NIYUGE666/cuddly-robot/docs/DESIGN.md

# 设计说明与校准

## 图纸版本

Rev B 将原理图改为单张 A0、有实际导线的功能分区图；四路从左到右依次为两级带通、两级移相、极性与幅度，右侧求和、底部电源。TL082 使用 A/B 放大单元和独立电源单元。修订仅改善表达及交换兼容性，PCB 铜线、器件编号和电路参数不变。BOM 的 Sheet 列表示功能分组，不代表 Rev B 的独立图纸页。

## 指标与实现

本设计选择文档中的方波方案，不采用三角波。电源为外部稳压 +12 V / 0 V / −12 V，不含市电电源模块。所有地均为同一 GND。NE555、CD4013 仅接 +12 V 和 GND；TL082 的 8 脚接 +12 V、4 脚接 −12 V，不能把 NE555 跨接在 24 V 两端。

信号链：NE555 → CD4013 /2 → 隔直、源幅度调整、TL082 缓冲 → 四路两级 MFB 带通 → 两级一阶全通 → 极性选择 → 幅度调整和缓冲 → 反相加法器 → 反相恢复 → 输出隔离电阻。

源输入为以 0 V 为中心的 ±5 V 方波。其正弦展开为

`v(t) = (20/π)[sin(ωt) + sin(3ωt)/3 + sin(5ωt)/5 + sin(7ωt)/7 + …]`，`ω = 2π × 1000`。

| 通道 | 频率 | 目标峰值 Vpk | 目标峰峰值 Vpp | 相对幅度 |
|---|---:|---:|---:|---:|
| H1 | 1 kHz | 6.3662 V | 12.7324 V | 1 |
| H3 | 3 kHz | 2.1221 V | 4.2441 V | 1/3 |
| H5 | 5 kHz | 1.2732 V | 2.5465 V | 1/5 |
| H7 | 7 kHz | 0.9095 V | 1.8189 V | 1/7 |

这些是各路**目标频率分量**的幅度，不是把 10 Vpp 方波的峰值 5 V 直接当作基波峰值。实际支路会含有少量带外谐波，推荐用示波器 FFT / 频谱测量，不能仅靠整条支路的总 Vpp 判断分量幅度。

## 方波发生及定标

U1=NE555P，R1=10 kΩ，R2=27 kΩ，RV1=20 kΩ，C1=10 nF。采用常见无稳态接法：2、6 脚接定时电容上端；7 脚为两个充放电电阻的中点；4 脚接 +12 V；5 脚以 10 nF 对地去耦。

`f555 ≈ 1.443 / [(R1 + 2(R2 + RV1_used)) C1]`。RV1 的使用阻值初设约 4.07 kΩ，得到约 2 kHz。

U2=CD4013BE，D1 接 /Q1，CLK1 接 NE555 输出。Q1 每个时钟沿翻转，从而产生 1 kHz、50% 占空比方波，不依赖 NE555 自身占空比。第一个触发器的 SET/RESET 接地；备用触发器 RESET 接 +12 V，其余输入接地，12/13 脚留空。CD4013 在 12 V 供电下可接受 NE555 的高电平；最终仍需实测电平裕量和占空比。

Q1 经 C3=10 µF/25 V 隔直，C3 正极朝 Q1。R3=1 MΩ 与 RV2=100 kΩ 提供对地直流回路，U3A 缓冲 RV2 的滑动端。等效隔直时间常数约 0.91 s，因此上电约 5 s 后再校准。RV2 初设滑动端对地约占总阻值 83.3%，微调至 TP2/SQ=10.00 Vpp。理论半周期下垂约 0.055%；这不是理想的直流电平移位器。

U3B 将 SQ 反相，提供 TP3/SQ_INV 作为辅助观察点；该单元没有悬空。

## 四路带通

每路由两个相同的多反馈 MFB 二阶带通串联构成，合计四阶。设中间节点为 N、反相端为 INV、输出为 O：

* 输入 → R1f → N；N → R2f → GND。
* N → C1f → O；N → C2f → INV。
* O → R3f → INV；运放同相端接 GND。

这里的 R1f/R2f/R3f 是拓扑参数名，具体参考号见 BOM 和原理图。

`H(s) = −s R3f C2f/R1f / [s² R3f C1f C2f + s(C1f+C2f) + 1/R1f + 1/R2f]`。

采用 `C1f=C2f=C`、`R1f=220 kΩ`、`R3f=470 kΩ`、`R2f=430 Ω + 200 Ω 多圈微调`。

理想模型：`f0 = sqrt[(1/R1f+1/R2f)/(R3f C²)]/(2π)`；`Q = π f0 R3f C`；中心增益 `−R3f/(2R1f) ≈ −1.0682`。每个中心频率处两级反相相消，两级增益约 1.141，从而给后续衰减调幅留下余量。

| 通道 | 滤波 IC | 每级 C1f/C2f | 两个中心频率电位器 | 有限带宽模型中电位器使用阻值 |
|---|---|---|---|---:|
| H1 | U4 | 10 nF | RV3、RV4 | 各约 104.92 Ω |
| H3 | U7 | 3.3 nF | RV8、RV9 | 各约 105.07 Ω |
| H5 | U10 | 2 nF | RV13、RV14 | 各约 83.55 Ω |
| H7 | U13 | 1.5 nF | RV18、RV19 | 各约 24.34 Ω |

每级 Q 约 15。滤波电容选 C0G/NP0 或薄膜、1%，同一级两只尽量匹配；不可随意换成有明显电压系数的高容值陶瓷电容。由于 TL082 带宽有限，特别是 7 kHz，**上表是单极点模型初值，不是免调实物阻值**。频率、增益和相位都需要校准。

## 相位与幅度

U5/U8/U11/U14 的两个单元各构成一个全通：同相端接输入经可调 R、C 对地形成的低通节点；反相端用两只相等 10 kΩ 电阻连接输入和输出。

`Hap(s) = (1−sRC)/(1+sRC)`，`φ = −2 arctan(ωRC)`。每级的 R 是 `100 Ω + 200 kΩ 电位器`，C 与所属通道的滤波电容值相同。两级串联提供接近一周的可调范围，再经反相器与三针跳线选择极性，能够覆盖完整 360° 的所需相位。

J1/J2/J3/J4 默认各接一个 **2–3 短路帽**，选择反相输出；1–2 选择不反相。**不可同时短接三针**，否则会连接两个反相输出。相位初设为每级约 −90°，两级合计 −180°，再经反相补偿到 0°。

| 通道 | 相位电位器 | 模型初设：每只使用阻值 | 幅度电位器 | 模型幅度比例：滑动端对地 / 总阻值 |
|---|---|---:|---|---:|
| H1 | RV5、RV6 | 15.797 kΩ | RV7 | 0.8804 |
| H3 | RV10、RV11 | 15.920 kΩ | RV12 | 0.8811 |
| H5 | RV15、RV16 | 15.723 kΩ | RV17 | 0.8827 |
| H7 | RV20、RV21 | 14.934 kΩ | RV22 | 0.8860 |

所有以可变电阻使用的电位器都已把 2 脚滑动端与 3 脚相连；断续接触时不会完全开路。相位电位器与滤波电位器调的是 1→2/3 的电阻，幅度电位器则作为三端分压器，不能混淆。

U6/U9/U12/U15 的 A 单元提供极性反相，B 单元缓冲幅度滑动端。每路幅度可从近 0 调至滤波后最大值。原始方波已具有 1/n 系数，因此各路幅度电位器的最终位置接近，而不是分别设置成 1、1/3、1/5、1/7。

## 求和、电源及接口

四路通过各自 100 kΩ 电阻进入 U16A，反馈也是 100 kΩ，得到反相和；U16B 用 100 kΩ / 100 kΩ 再反相，得到同相输出。R69=100 Ω 串联隔离到输出端。求和及反相电阻建议用 0.1%。

| 接口 / 测试点 | 含义 |
|---|---|
| J5-1 / J5-2 / J5-3 | +12 V / GND / −12 V，极性必须核对 |
| J6-1 / J6-2 | OUT / GND |
| TP1 / TP2 / TP3 | 2 kHz 时钟 / SQ / 反相 SQ |
| TP4 / TP7 / TP10 / TP13 | H1/H3/H5/H7 两级带通输出 |
| TP5 / TP8 / TP11 / TP14 | H1/H3/H5/H7 两级全通输出，极性选择前 |
| TP6 / TP9 / TP12 / TP15 | 四路最终幅度缓冲输出 |
| TP16 / TP17 / TP18 | SUM_RAW / OUT / GND |

每个 IC 配 100 nF 正电源去耦，TL082 另外配 100 nF 负电源去耦。入口两只 47 µF/25 V 电解分别跨接正、负电源；**负电源电解正极接 GND**。推荐外部稳压电源每路可供 200 mA，首次限流上电并确认无异常后再提高限流。没有板载电源极性保护。

示波器使用高阻 10× 探头，输出负载建议 ≥100 kΩ；1 MΩ 仪器输入更合适。不可接 50 Ω 终端，也不作为耳机/扬声器驱动器。输出电阻对 100 kΩ 负载的幅度影响约 −0.1%。

## 实物校准流程

1. 断电检查焊接、电源极性和 IC 方向。22 只电位器按上表预置；J1–J4 各放一个 2–3 短路帽。幅度先调小。上电检查各 TL082 的 8/4 脚电源以及 U1/U2 电源，等待约 5 s。
2. 调 RV1，使 TP1≈2.000 kHz、TP2≈1.000 kHz；观察 TP2 占空比约 50%。调 RV2，使 TP2 为 10.00 Vpp、平均电压接近 0 V。温漂后可能需要重调频率。
3. 对每路单独校准两个滤波段。用 FFT 分析目标谐波，在目标频率固定时交替小幅调整两个 200 Ω 电位器，使各级对应的目标谐波幅度最大。若有信号发生器，可临时隔离源驱动，再用所属频率的正弦波校准；**不可把外部发生器直接并接到正在工作的 SQ 输出**。
4. 示波器以 SQ 的上升沿为共同时间原点。调整两只相位电位器及必要的极性跳线，使各通道目标谐波在该时间点为正向过零，即 `sin(nωt)` 的相位约 0°。建议用 FFT 相位/拟合正弦检查，因为残余谐波会影响肉眼判断过零。对每路只看自己的目标频率，不能把所有波形的周期误认为相同。
5. 交替微调相位与幅度，令四路目标分量达到表中 Vpk 值。使用同一测量通道、同一探头衰减倍率。建议目标：幅度比例误差 ≤2%，对应谐波相位误差 ≤2°；这是待实物验证的调试目标，不是自动检查证实的实物指标。
6. 测 TP16/TP17，确认四项合成近似方波；记录频率、源 Vpp、四路频谱幅度/相位及合成波形。过冲属于有限项傅里叶合成的正常现象，不能通过误调某一路幅度来强行消除。

若希望最终 OUT 总 Vpp 约 10 V，可把四路同时缩放约 `10/11.84≈0.845`，保留相对幅度关系。这会改变绝对傅里叶系数；默认设计按原始 10 Vpp 方波的傅里叶系数校准。

## PCB 和装配

板外形 229 × 231 mm，双层，FR-4 1.6 mm，建议 1 oz 铜。采用较大的插件实验板便于焊接、测量和反复调试，未针对最低板价或最小面积优化。所有信号/电源线最小宽度 0.25 mm，间距下限 0.20 mm，过孔 0.60/0.30 mm。低频电路仍需关注公共地阻抗；本版采用明确的地走线，没有宣称经过 EMI/串扰或电源完整性验证。

固定电阻是 DIN0207、7.62 mm 脚距；非极性电容是 5 mm 脚距；电解是直径 5 mm、2 mm 脚距；多圈电位器为 Bourns 3296W 立式封装。采购时逐一核对实物尺寸、特别是 47 µF/25 V 电解。TL082/NE555 为 DIP-8，CD4013 为 DIP-14，宽度均为 7.62 mm。可选配 IC 插座；BOM 中测试点是焊盘本身，无需购买独立器件。另需四个 2.54 mm 短路帽。

设计尚未打样。原理图/ERC、PCB/DRC 和线性分析不能替代电源启动、器件容差、振荡、失调和实测调试，也不能证明嘉立创导入后的库映射正确。
