NIYUGE666/cuddly-robot/docs/frequency_response.png

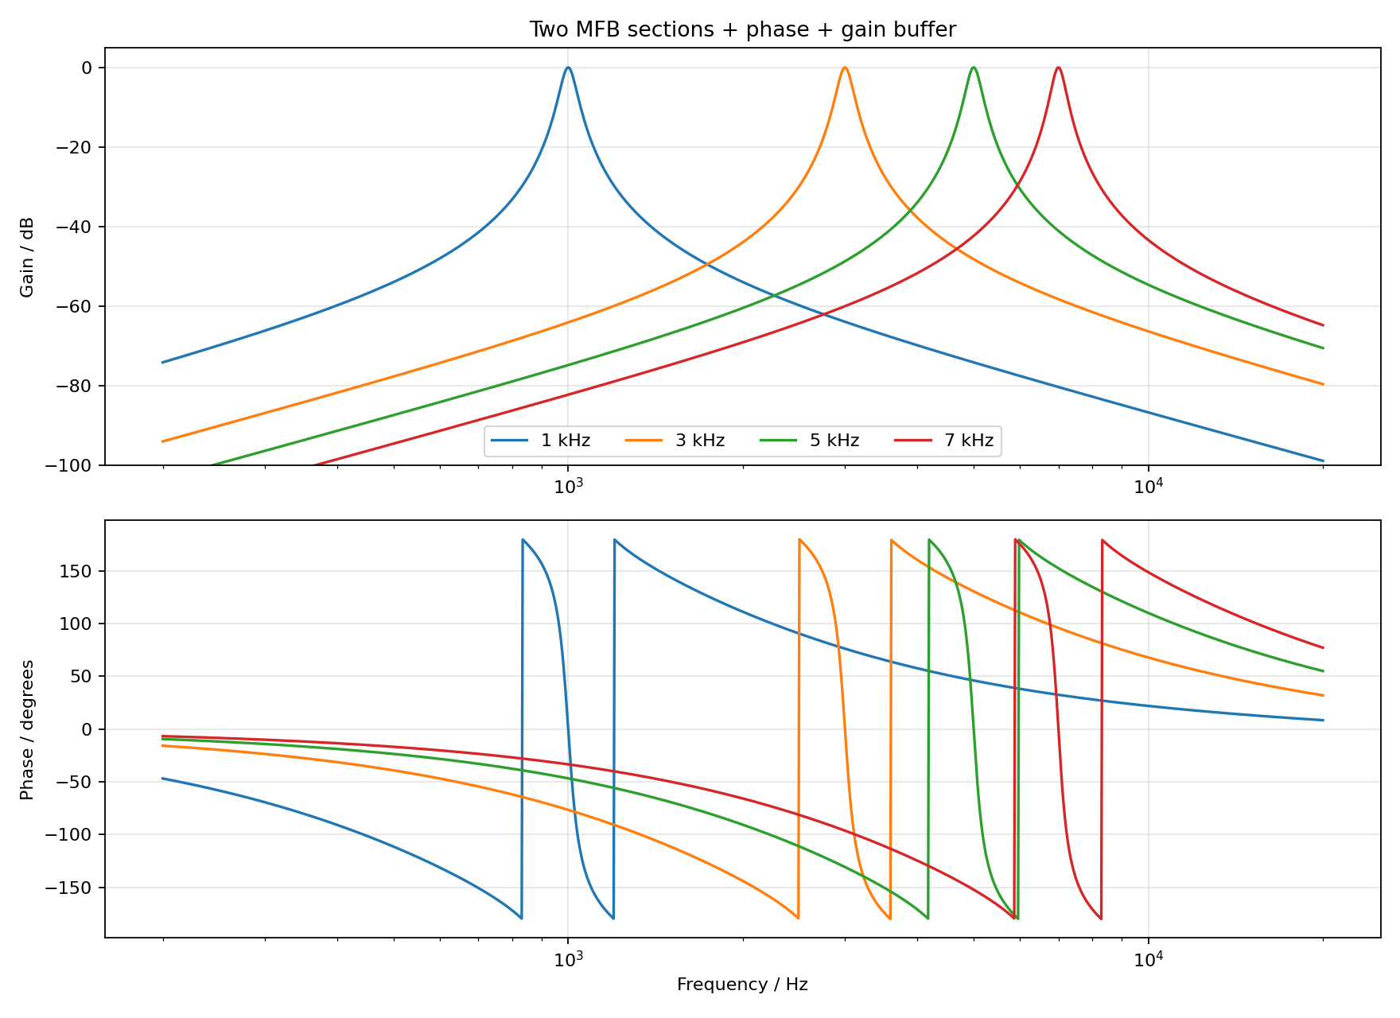
docs/frequency_response.png
