NIYUGE666/cuddly-robot/docs/wired_branch_preview.png

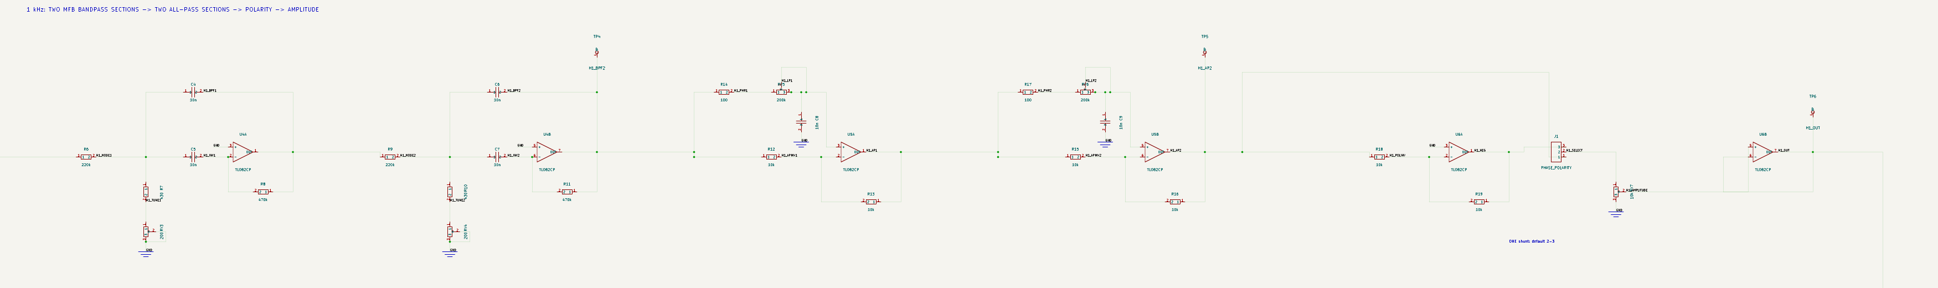
docs/wired_branch_preview.png
