NIYUGE666/cuddly-robot/fabrication/README.txt

Rev B prototype manufacturing output. Source: hardware/waveform.kicad_pcb
2 layers, FR4 1.6mm, suggested 1oz copper; outline 229 x 231 mm.
These are manufacturing graphics, NOT an editable schematic/PCB project.
No prototype has been manufactured. Verify dimensions, materials, assembly and import before ordering.
