NIYUGE666/cuddly-robot/docs/VALIDATION.md

# 验证记录 — Rev B

Rev B 修正了旧版元件网格排版，使用分开的 TL082 放大/电源单元、实际信号线、标准局部网络标签和明确的接地点；不是要求用户把旧版散落元件自行连线。

本记录区分本地 EDA 检查、数值模型、软件导入和硬件实测。机器可读结果位于 `validation/`。

| 内容 | 状态 | 证据与范围 |
|---|---|---|
| 仓库既有成果检查 | 完成 | 起始仅 README，Git 工作区干净；没有覆盖用户已有设计 |
| 原理图生成、符号/封装库 | 完成 | 单页 A0 实际连线分区图，自包含库，可由 KiCad CLI 解析 |
| PCB 铜线及封装保留 | 通过 | `physical_preservation.json`，与 Rev A 比较所有线段/过孔和引脚位置一致，网络仅增加局部根路径前缀 |
| 原理图 ERC | 通过 | `ERC.rpt`，0 违规，未关闭检查或添加违规豁免 |
| 双层 PCB 全部布线 | 完成 | 190 封装，2522 段线、151 过孔，229 × 231 mm |
| PCB DRC 和原理图一致性 | 通过 | `DRC.rpt`，0 违规、0 未连接、0 一致性问题 |
| 独立引脚网络比较 | 通过 | `connections.json`，清单/导出的网表/PCB 共 491 引脚一致 |
| EAGLE XML 交换文件 | 通过有限检查 | `eagle_exchange.json`，XML 可解析，489 个接网引脚的原理图/PCB 引用一致 |
| EAGLE PCB 实际导入回读 | 通过 | KiCad 9 EAGLE 导入器读取 190 元件、2522 走线和 151 过孔，引脚网络一致 |
| EAGLE PCB 回读后 DRC | 通过 | `EAGLE_roundtrip_DRC.rpt`，0 违规、0 未连接；与专业版导入检查独立 |
| 单页 A0 PDF、PCB SVG、BOM | 完成 | 由 EDA 源文件导出或从统一元件清单生成 |
| 滤波/移相线性计算 | 通过模型断言 | `analysis.json`；TL082 A0=200000、GBW=3 MHz 的单极点近似 |
| NE555/CD4013 瞬态启动仿真 | 未运行 | 发生器按常用电路和公式设计；分析从 SQ 处的理想 ±5 V 方波开始 |
| 厂家完整 SPICE / 容差分析 | 未运行 | 不把单极点计算称为厂家模型仿真；未做 Monte Carlo |
| 嘉立创 EDA 专业版实际导入 | 未验证 | 当前环境无该 GUI；KiCad 9/EAGLE XML 版本接受程度待实际验证 |
| 专业版内 ERC/DRC、封装物料映射 | 未验证 | 需按导入说明核对 |
| 实物打样、占空比、电平、温漂 | 未验证 | 必须校准；没有“免调”“量产验证”结论 |

## 模型结果

四路各自目标频率分量经校准为 6.3662 / 2.1221 / 1.2732 / 0.9095 Vpk、相位约 0°。计算保留 1–101 次奇次谐波通过各滤波器后的带外残留，没有把滤波器输出人为替换为纯正弦。

包含带外泄漏、求和运放带宽和 100 kΩ 负载后，合成输出中 1/3/5/7 次分量峰值约为 6.3617 / 2.1149 / 1.2603 / 0.9013 V，所选四项相对幅度比例最大误差约 0.95%，相位偏差绝对值小于 0.70°。合成总 Vpp 约 11.8377 V，理想四项傅里叶合成为 11.8423 Vpp。输出模型最大斜率约 0.159 V/µs，未加入非线性压摆或饱和模型。

这些数值依赖校准和所选线性模型，不是实物精度保证。TL082 的失调、噪声、输出摆幅/电流、实际 GBW 差异、器件容差和公共地阻抗仍需验证。

## 环境与 GitHub

环境已从不可用状态恢复，KiCad 9.0.2、系统 `pcbnew` 和 C++ 编译器可运行。联网操作遭遇平台代理 `proxy:8080` 无法连接，而不是已证实的 GitHub 权限问题。未要求新 token、未绕过代理、未修改网络访问范围。Git 本地提交与远端推送的实际结果以最终交付报告为准。
