NIYUGE666/cuddly-robot/docs/schematic.pdf

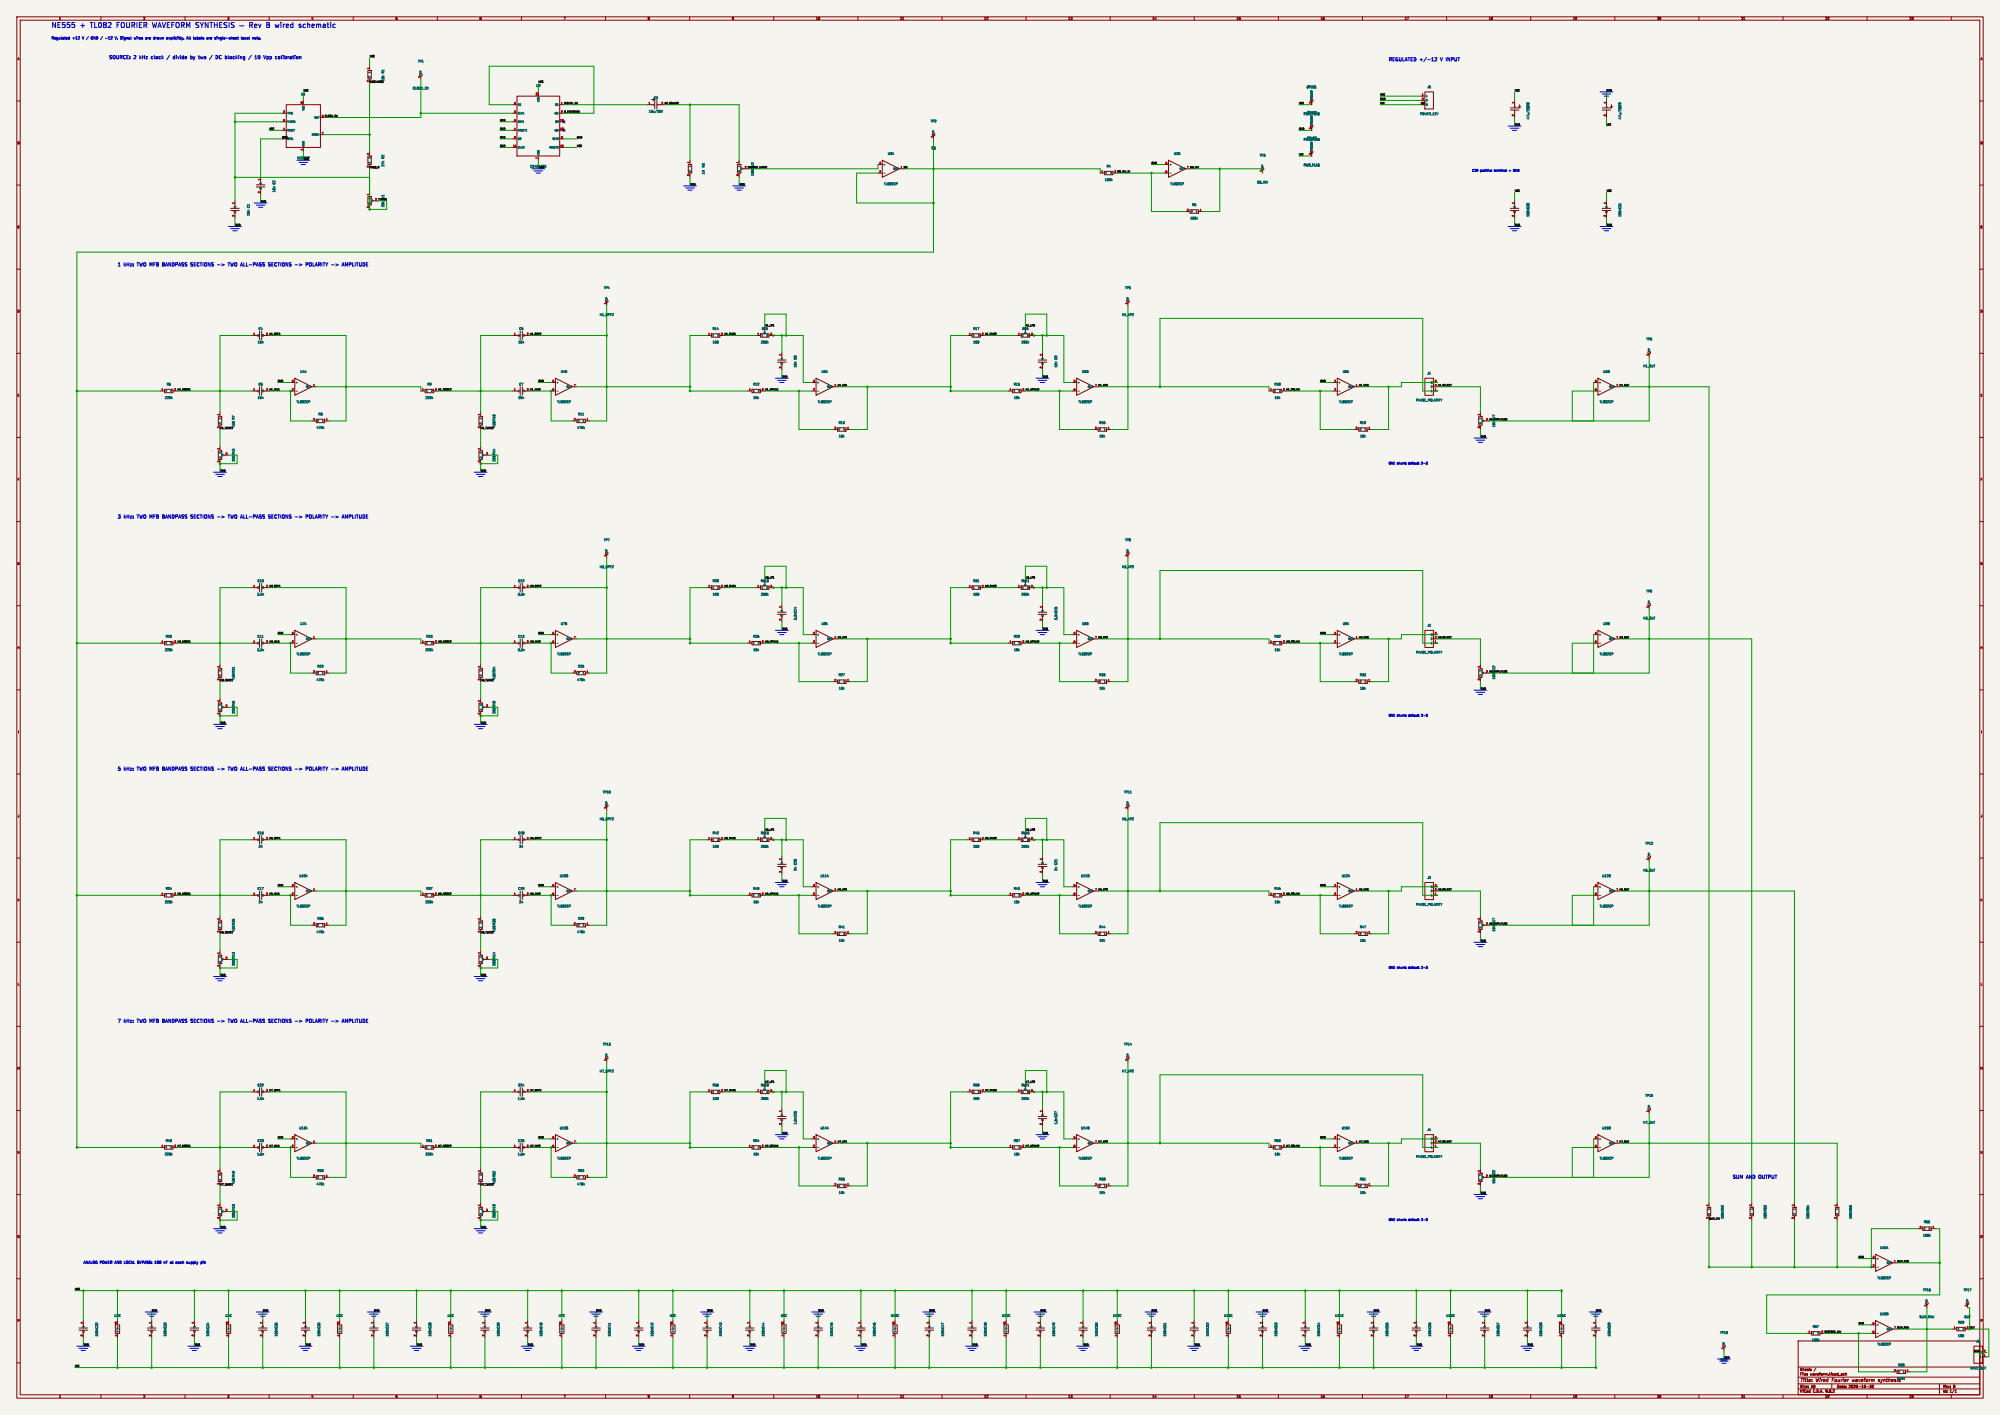
[picture p4: page 1]

ANALOG POWER AND LOCAL BYPASS: 100 nF at each supply pin

File: waveform.kicad_sch Sheet: /
Id: 1/1 Title: Wired Fourier waveform synthesis
