NIYUGE666/cuddly-robot/(list of files, drawings)

Other design files:
schematic_layout.json
