NIYUGE666/cuddly-robot/hardware/waveform.brd

## EAGLE design hardware/waveform.brd (2026-10-29)

Schematic: waveform.sch

Parts:
C1, C2, C4, C5, C6, C7, C8, C9: 10n; C_Disc_D5.0mm_W2.5mm_P5.00mm
C3: 10u/25V; CP_Radial_D5.0mm_P2.00mm
C10, C11, C12, C13, C14, C15: 3.3n; C_Disc_D5.0mm_W2.5mm_P5.00mm
C16, C17, C18, C19, C20, C21: 2n; C_Disc_D5.0mm_W2.5mm_P5.00mm
C22, C23, C24, C25, C26, C27: 1.5n; C_Disc_D5.0mm_W2.5mm_P5.00mm
C28, C29: 47u/25V; CP_Radial_D5.0mm_P2.00mm
C30, C31, C32, C33, C34, C35, C36, C37, C38, C39, C40, C41, C42, C43, C44, C45, C46, C47, C48, C49, C50, C51, C52, C53, C54, C55, C56, C57, C58, C59: 100n; C_Disc_D5.0mm_W2.5mm_P5.00mm
J1, J2, J3, J4: PHASE_POLARITY; PinHeader_1x03_P2.54mm_Vertical
J5: POWER_12V; PinHeader_1x03_P2.54mm_Vertical
J6: WAVE_OUT; PinHeader_1x02_P2.54mm_Vertical
R1, R12, R13, R15, R16, R18, R19, R26, R27, R29, R30, R32, R33, R40, R41, R43, R44, R46, R47, R54, R55, R57, R58, R60, R61: 10k; R_Axial_DIN0207_L6.3mm_D2.5mm_P7.62mm_Horizontal
R2: 27k; R_Axial_DIN0207_L6.3mm_D2.5mm_P7.62mm_Horizontal
R3: 1M; R_Axial_DIN0207_L6.3mm_D2.5mm_P7.62mm_Horizontal
R4, R5, R62, R63, R64, R65, R66, R67, R68: 100k; R_Axial_DIN0207_L6.3mm_D2.5mm_P7.62mm_Horizontal
R6, R9, R20, R23, R34, R37, R48, R51: 220k; R_Axial_DIN0207_L6.3mm_D2.5mm_P7.62mm_Horizontal
R7, R10, R21, R24, R35, R38, R49, R52: 430; R_Axial_DIN0207_L6.3mm_D2.5mm_P7.62mm_Horizontal
R8, R11, R22, R25, R36, R39, R50, R53: 470k; R_Axial_DIN0207_L6.3mm_D2.5mm_P7.62mm_Horizontal
R14, R17, R28, R31, R42, R45, R56, R59, R69: 100; R_Axial_DIN0207_L6.3mm_D2.5mm_P7.62mm_Horizontal
RV1: 20k; Potentiometer_Bourns_3296W_Vertical
RV2: 100k; Potentiometer_Bourns_3296W_Vertical
RV3, RV4, RV8, RV9, RV13, RV14, RV18, RV19: 200; Potentiometer_Bourns_3296W_Vertical
RV5, RV6, RV10, RV11, RV15, RV16, RV20, RV21: 200k; Potentiometer_Bourns_3296W_Vertical
RV7, RV12, RV17, RV22: 10k; Potentiometer_Bourns_3296W_Vertical
TP1: CLOCK_2K; TestPoint_THTPad_D1.5mm_Drill0.7mm
TP2: SQ; TestPoint_THTPad_D1.5mm_Drill0.7mm
TP3: SQ_INV; TestPoint_THTPad_D1.5mm_Drill0.7mm
TP4: H1_BPF2; TestPoint_THTPad_D1.5mm_Drill0.7mm
TP5: H1_AP2; TestPoint_THTPad_D1.5mm_Drill0.7mm
TP6: H1_OUT; TestPoint_THTPad_D1.5mm_Drill0.7mm
TP7: H3_BPF2; TestPoint_THTPad_D1.5mm_Drill0.7mm
TP8: H3_AP2; TestPoint_THTPad_D1.5mm_Drill0.7mm
TP9: H3_OUT; TestPoint_THTPad_D1.5mm_Drill0.7mm
TP10: H5_BPF2; TestPoint_THTPad_D1.5mm_Drill0.7mm
TP11: H5_AP2; TestPoint_THTPad_D1.5mm_Drill0.7mm
TP12: H5_OUT; TestPoint_THTPad_D1.5mm_Drill0.7mm
TP13: H7_BPF2; TestPoint_THTPad_D1.5mm_Drill0.7mm
TP14: H7_AP2; TestPoint_THTPad_D1.5mm_Drill0.7mm
TP15: H7_OUT; TestPoint_THTPad_D1.5mm_Drill0.7mm
TP16: SUM_RAW; TestPoint_THTPad_D1.5mm_Drill0.7mm
TP17: OUT; TestPoint_THTPad_D1.5mm_Drill0.7mm
TP18: GND; TestPoint_THTPad_D1.5mm_Drill0.7mm
U1: NE555P; DIP-8_W7.62mm
U2: CD4013BE; DIP-14_W7.62mm
U3, U4, U5, U6, U7, U8, U9, U10, U11, U12, U13, U14, U15, U16: TL082CP; DIP-8_W7.62mm

Connections:
AC_SQUARE: C3.2, R3.1, RV2.1
CLOCK_2K: TP1.1, U1.3, U2.3
CTRL: C2.1, U1.5
DIGITAL_1K: C3.1, U2.1
DISCHARGE: R1.2, R2.1, U1.7
D_FEEDBACK: U2.2, U2.5
FREQ_R: R2.2, RV1.1
GND: C1.2, C2.2, C8.2, C9.2, C14.2, C15.2, C20.2, C21.2, C26.2, C27.2, C28.2, C29.1, C30.2, C31.2, C32.2, C33.1, C34.2, C35.1, C36.2, C37.1, C38.2, C39.1, C40.2, C41.1, C42.2, C43.1, C44.2, C45.1, C46.2, C47.1, C48.2, C49.1, C50.2, C51.1, C52.2, C53.1, C54.2, C55.1, C56.2, C57.1, C58.2, C59.1, J5.2, J6.2, R3.2, RV2.3, RV3.2, RV3.3, RV4.2, RV4.3, RV7.3, RV8.2, RV8.3, RV9.2, RV9.3, RV12.3, RV13.2, RV13.3, RV14.2, RV14.3, RV17.3, RV18.2, RV18.3, RV19.2, RV19.3, RV22.3, TP18.1, U1.1, U2.4, U2.6, U2.7, U2.8, U2.9, U2.11, U3.5, U4.3, U4.5, U6.3, U7.3, U7.5, U9.3, U10.3, U10.5, U12.3, U13.3, U13.5, U15.3, U16.3, U16.5
H1_AMPLITUDE: RV7.2, U6.5
H1_AP1: R13.1, R15.1, R17.1, U5.1
H1_AP2: J1.1, R16.1, R18.1, TP5.1, U5.7
H1_APINV1: R12.2, R13.2, U5.2
H1_APINV2: R15.2, R16.2, U5.6
H1_BPF1: C4.2, R8.1, R9.1, U4.1
H1_BPF2: C6.2, R11.1, R12.1, R14.1, TP4.1, U4.7
H1_INV1: C5.2, R8.2, U4.2
H1_INV2: C7.2, R11.2, U4.6
H1_LP1: C8.1, RV5.2, RV5.3, U5.3
H1_LP2: C9.1, RV6.2, RV6.3, U5.5
H1_NEG: J1.3, R19.1, U6.1
H1_NODE1: C4.1, C5.1, R6.2, R7.1
H1_NODE2: C6.1, C7.1, R9.2, R10.1
H1_OUT: R62.1, TP6.1, U6.6, U6.7
H1_PHR1: R14.2, RV5.1
H1_PHR2: R17.2, RV6.1
H1_POLINV: R18.2, R19.2, U6.2
H1_SELECT: J1.2, RV7.1
H1_TUNE1: R7.2, RV3.1
H1_TUNE2: R10.2, RV4.1
H3_AMPLITUDE: RV12.2, U9.5
H3_AP1: R27.1, R29.1, R31.1, U8.1
H3_AP2: J2.1, R30.1, R32.1, TP8.1, U8.7
H3_APINV1: R26.2, R27.2, U8.2
H3_APINV2: R29.2, R30.2, U8.6
H3_BPF1: C10.2, R22.1, R23.1, U7.1
H3_BPF2: C12.2, R25.1, R26.1, R28.1, TP7.1, U7.7
H3_INV1: C11.2, R22.2, U7.2
H3_INV2: C13.2, R25.2, U7.6
H3_LP1: C14.1, RV10.2, RV10.3, U8.3
H3_LP2: C15.1, RV11.2, RV11.3, U8.5
H3_NEG: J2.3, R33.1, U9.1
H3_NODE1: C10.1, C11.1, R20.2, R21.1
H3_NODE2: C12.1, C13.1, R23.2, R24.1
H3_OUT: R63.1, TP9.1, U9.6, U9.7
H3_PHR1: R28.2, RV10.1
H3_PHR2: R31.2, RV11.1
H3_POLINV: R32.2, R33.2, U9.2
H3_SELECT: J2.2, RV12.1
H3_TUNE1: R21.2, RV8.1
H3_TUNE2: R24.2, RV9.1
H5_AMPLITUDE: RV17.2, U12.5
H5_AP1: R41.1, R43.1, R45.1, U11.1
H5_AP2: J3.1, R44.1, R46.1, TP11.1, U11.7
H5_APINV1: R40.2, R41.2, U11.2
H5_APINV2: R43.2, R44.2, U11.6
H5_BPF1: C16.2, R36.1, R37.1, U10.1
H5_BPF2: C18.2, R39.1, R40.1, R42.1, TP10.1, U10.7
H5_INV1: C17.2, R36.2, U10.2
H5_INV2: C19.2, R39.2, U10.6
H5_LP1: C20.1, RV15.2, RV15.3, U11.3
H5_LP2: C21.1, RV16.2, RV16.3, U11.5
H5_NEG: J3.3, R47.1, U12.1
H5_NODE1: C16.1, C17.1, R34.2, R35.1
H5_NODE2: C18.1, C19.1, R37.2, R38.1
H5_OUT: R64.1, TP12.1, U12.6, U12.7
H5_PHR1: R42.2, RV15.1
H5_PHR2: R45.2, RV16.1
H5_POLINV: R46.2, R47.2, U12.2
H5_SELECT: J3.2, RV17.1
H5_TUNE1: R35.2, RV13.1
H5_TUNE2: R38.2, RV14.1
H7_AMPLITUDE: RV22.2, U15.5
H7_AP1: R55.1, R57.1, R59.1, U14.1
H7_AP2: J4.1, R58.1, R60.1, TP14.1, U14.7
H7_APINV1: R54.2, R55.2, U14.2
H7_APINV2: R57.2, R58.2, U14.6
H7_BPF1: C22.2, R50.1, R51.1, U13.1
H7_BPF2: C24.2, R53.1, R54.1, R56.1, TP13.1, U13.7
H7_INV1: C23.2, R50.2, U13.2
H7_INV2: C25.2, R53.2, U13.6
H7_LP1: C26.1, RV20.2, RV20.3, U14.3
H7_LP2: C27.1, RV21.2, RV21.3, U14.5
H7_NEG: J4.3, R61.1, U15.1
H7_NODE1: C22.1, C23.1, R48.2, R49.1
H7_NODE2: C24.1, C25.1, R51.2, R52.1
H7_OUT: R65.1, TP15.1, U15.6, U15.7
H7_PHR1: R56.2, RV20.1
H7_PHR2: R59.2, RV21.1
H7_POLINV: R60.2, R61.2, U15.2
H7_SELECT: J4.2, RV22.1
H7_TUNE1: R49.2, RV18.1
H7_TUNE2: R52.2, RV19.1
OUT: J6.1, R69.2, TP17.1
RESTORE_INV: R67.2, R68.2, U16.6
SOURCE_WIPER: RV2.2, U3.3
SQ: R4.1, R6.1, R20.1, R34.1, R48.1, TP2.1, U3.1, U3.2
SQ_INV: R5.1, TP3.1, U3.7
SQ_INV_IN: R4.2, R5.2, U3.6
SUM_INV: R62.2, R63.2, R64.2, R65.2, R66.2, U16.2
SUM_NEG: R66.1, R67.1, U16.1
SUM_RAW: R68.1, R69.1, TP16.1, U16.7
TIMING: C1.1, RV1.2, RV1.3, U1.2, U1.6
VCC: C28.1, C30.1, C31.1, C32.1, C34.1, C36.1, C38.1, C40.1, C42.1, C44.1, C46.1, C48.1, C50.1, C52.1, C54.1, C56.1, C58.1, J5.1, R1.1, U1.4, U1.8, U2.10, U2.14, U3.8, U4.8, U5.8, U6.8, U7.8, U8.8, U9.8, U10.8, U11.8, U12.8, U13.8, U14.8, U15.8, U16.8
VEE: C29.2, C33.2, C35.2, C37.2, C39.2, C41.2, C43.2, C45.2, C47.2, C49.2, C51.2, C53.2, C55.2, C57.2, C59.2, J5.3, U3.4, U4.4, U5.4, U6.4, U7.4, U8.4, U9.4, U10.4, U11.4, U12.4, U13.4, U14.4, U15.4, U16.4

Notes on the sheet:
NE555 + TL082 FOURIER WAVEFORM SYNTHESIS — Rev B wired schematic
Regulated +12 V / GND / -12 V. Signal wires are drawn explicitly. All labels are single-sheet local nets.
SOURCE: 2 kHz clock / divide by two / DC blocking / 10 Vpp calibration
1 kHz: TWO MFB BANDPASS SECTIONS -> TWO ALL-PASS SECTIONS -> POLARITY -> AMPLITUDE
ONE shunt: default 2-3
3 kHz: TWO MFB BANDPASS SECTIONS -> TWO ALL-PASS SECTIONS -> POLARITY -> AMPLITUDE
5 kHz: TWO MFB BANDPASS SECTIONS -> TWO ALL-PASS SECTIONS -> POLARITY -> AMPLITUDE
7 kHz: TWO MFB BANDPASS SECTIONS -> TWO ALL-PASS SECTIONS -> POLARITY -> AMPLITUDE
SUM AND OUTPUT
REGULATED +/-12 V INPUT
C29 positive terminal = GND
ANALOG POWER AND LOCAL BYPASS: 100 nF at each supply pin

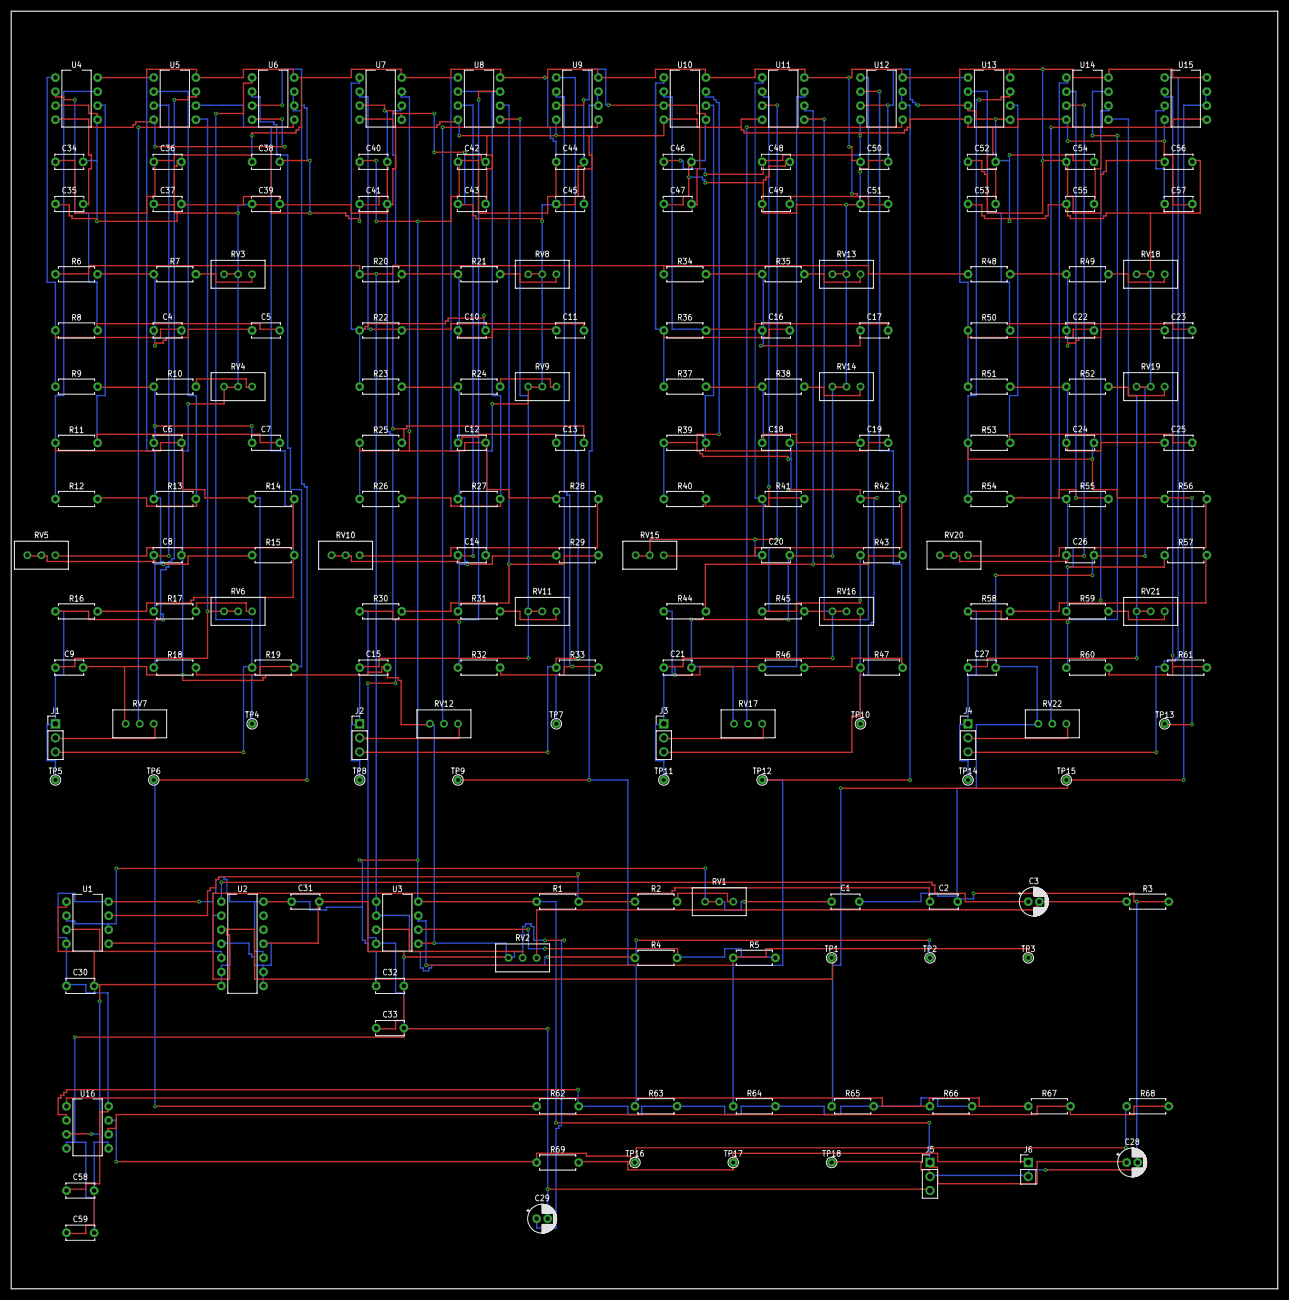
[picture p6: board waveform.brd from above]

Board: 2 copper layers, 229.0 x 231.0 mm, 190 parts (0 on the bottom side), 104 nets.
