NIYUGE666/cuddly-robot/(commit log)

2026-10-29 Add calibrated NE555 TL082 waveform synthesis design and editable CAD exchanges
    Include six schematic sheets, routed two-layer PCB, BOM, calibration notes, KiCad and EAGLE import packages, and prototype Gerbers. Record passing ERC, DRC, connectivity, and EAGLE PCB round-trip checks; EasyEDA Pro GUI import and hardware validation remain pending.
    [BOM.csv, BOM_grouped.csv, harmonic_1.kicad_sch, harmonic_3.kicad_sch, harmonic_5.kicad_sch, harmonic_7.kicad_sch, power_sum.kicad_sch, source.kicad_sch]
2026-10-29 Normalize generated text exports and preserve reusable packaging outputs
    [BOM.csv, BOM_grouped.csv]
2026-10-29 Trim trailing blank line in bundled footprint license
2026-10-29 Redraw waveform schematic as wired functional blocks for readable EDA import
    Split TL082 amplifier and power units, replace the component grid with a single wired schematic and local net labels, and update both KiCad and EAGLE exchanges. Preserve all PCB copper and pad geometry; verify 491 pin connections, zero ERC/DRC issues, and EAGLE PCB round-trip checks. Add clearly named RevB wired download packages.
    [harmonic_1.kicad_sch, harmonic_3.kicad_sch, harmonic_5.kicad_sch, harmonic_7.kicad_sch, power_sum.kicad_sch, schematic_layout.json, source.kicad_sch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]
